Alexandr-Filatov/Invertor-Test/3D/Втулка М4 6х10.STEP

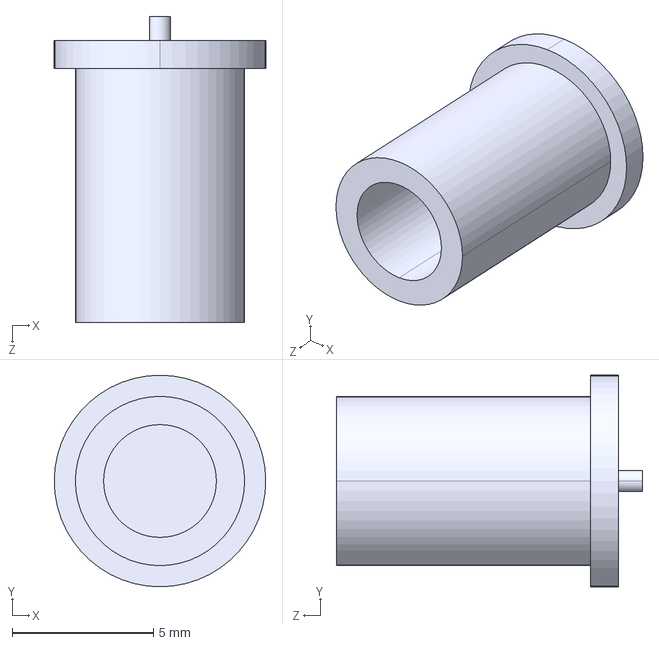
[picture p1: CAD file, 2024-11-04]
3D/Втулка М4 6х10.STEP
7.50 x 7.50 x 10.8 mm
