Alexandr-Filatov/Invertor-Test/3D/1-188275-0.stp

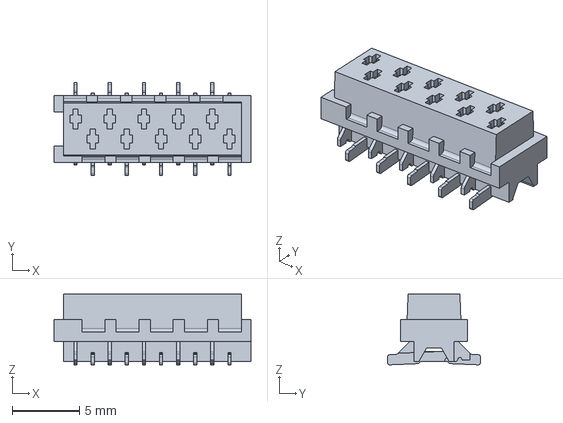
[picture p2: CAD file, 2024-11-04]
3D/1-188275-0.stp
14.6 x 6.90 x 5.25 mm
