Alexandr-Filatov/Invertor-Test/3D/PG-HSOF-8-1.STEP

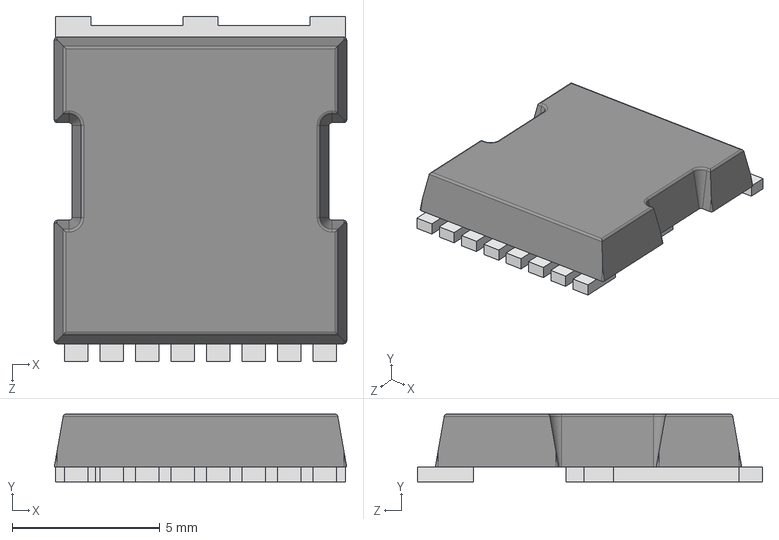
[picture p3: CAD file, 2024-11-04]
3D/PG-HSOF-8-1.STEP
9.90 x 2.30 x 11.7 mm
