Alexandr-Filatov/Invertor-Test/Power.kicad_pcb

## KiCad design Power.kicad_pcb (2024-11-04)

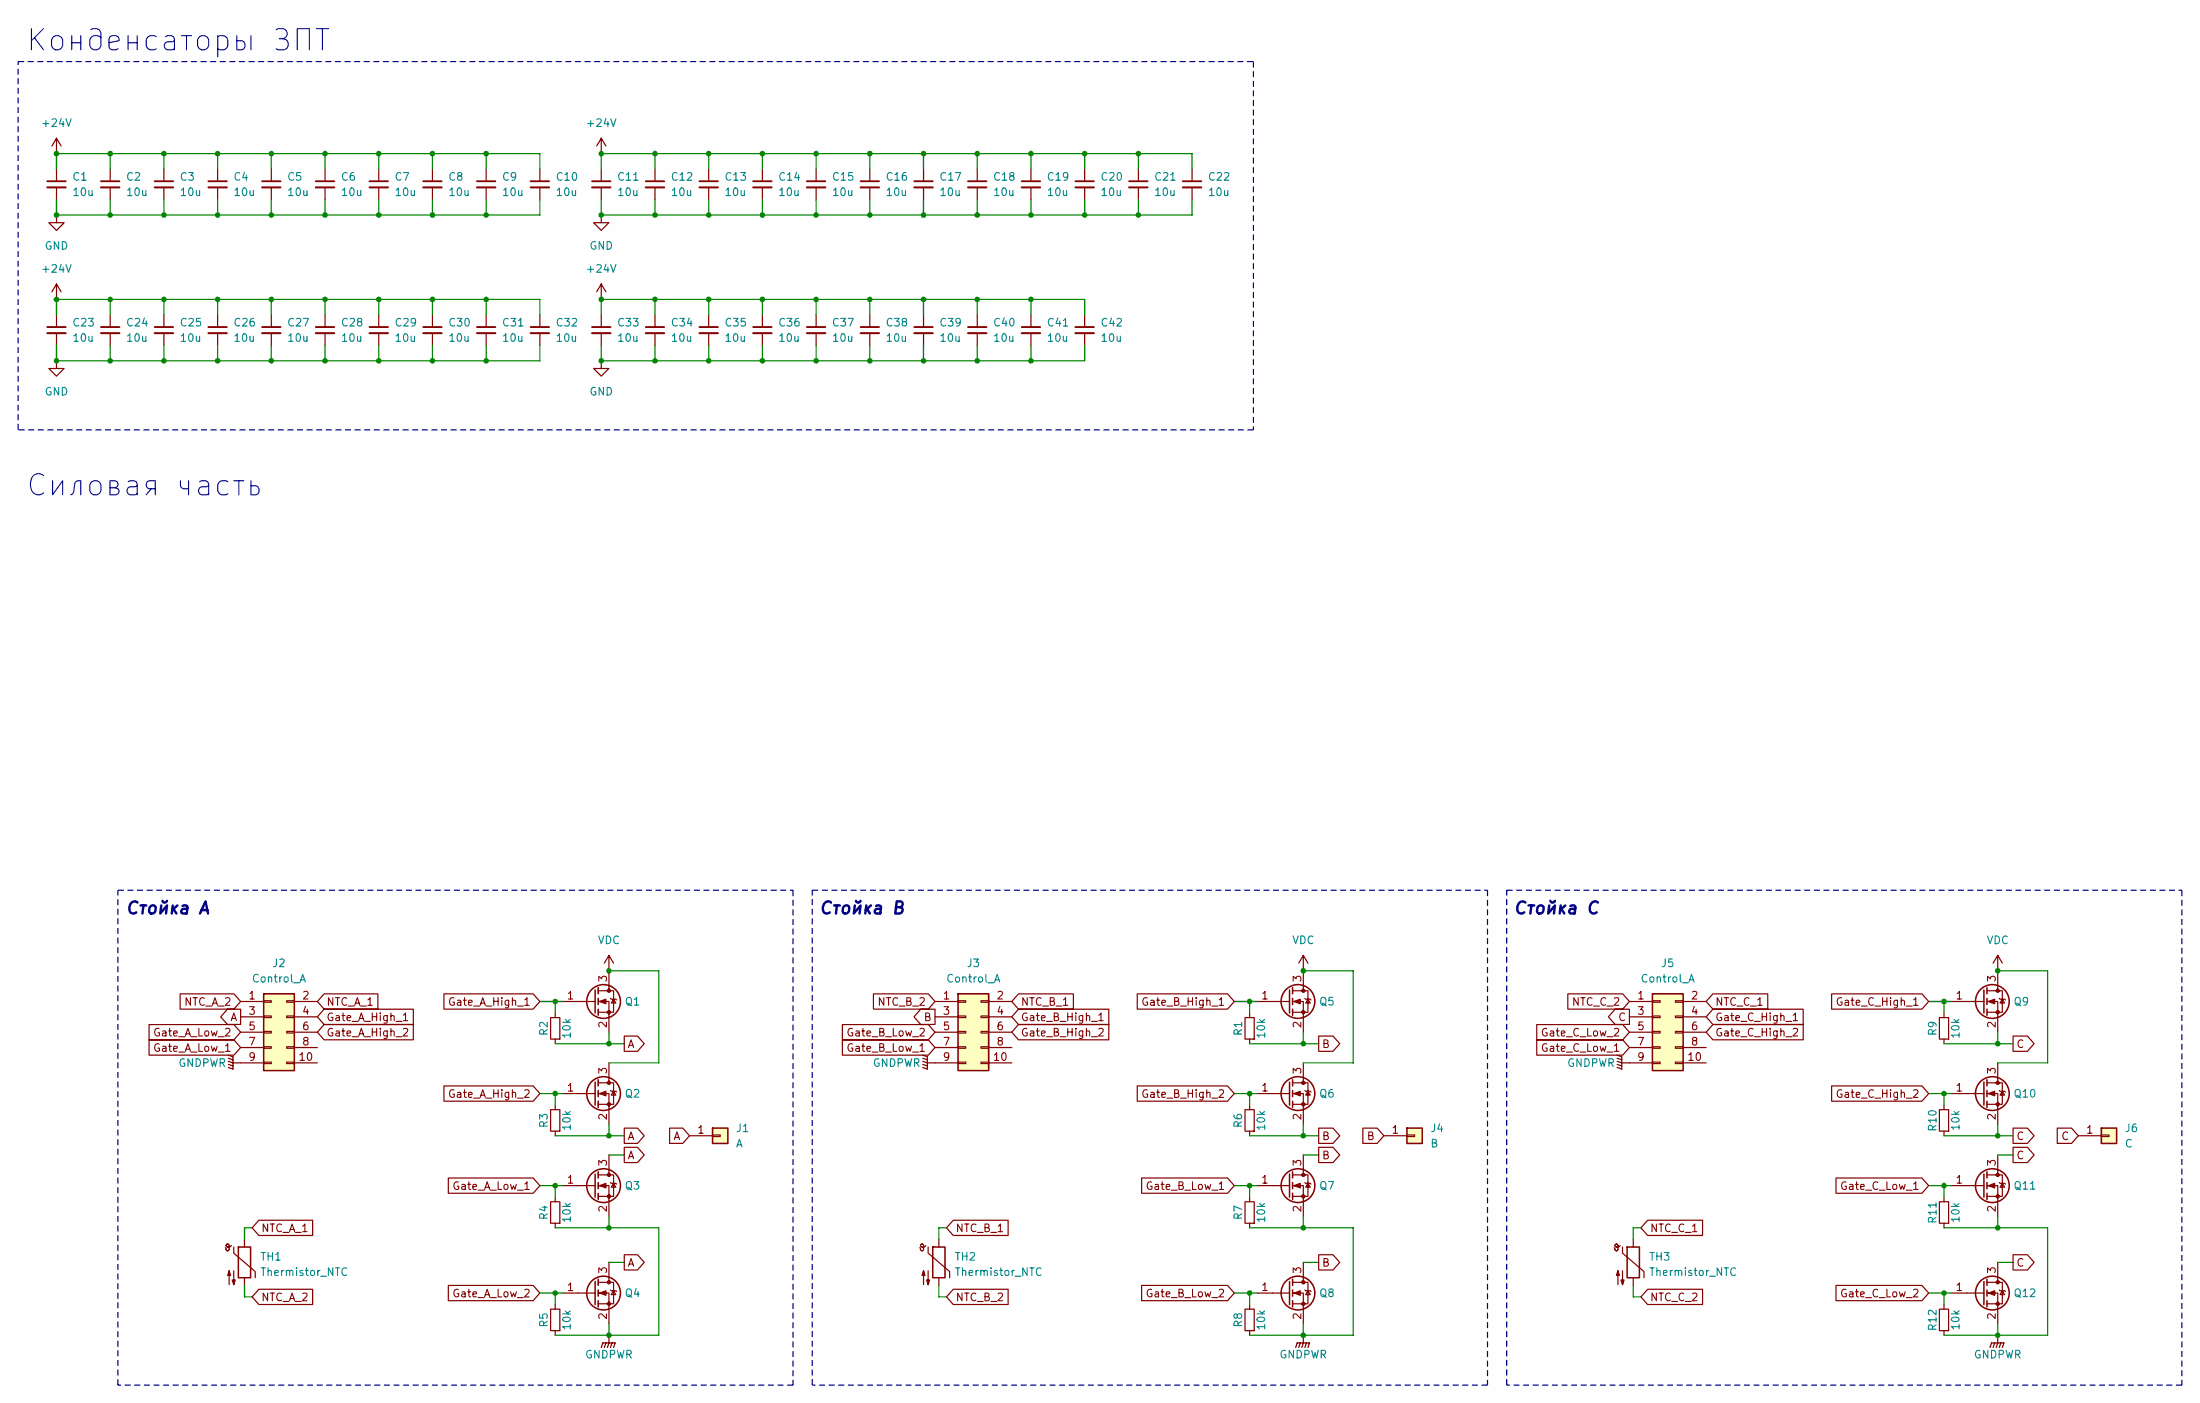
[picture p4: schematic Power.kicad_sch]

Parts:
C1, C2, C3, C4, C5, C6, C7, C8, C9, C10, C11, C12, C13, C14, C15, C16, C17, C18, C19, C20, C21, C22, C23, C24, C25, C26, C27, C28, C29, C30, C31, C32, C33, C34, C35, C36, C37, C38, C39, C40, C41, C42: 10u; C_1210_3225Metric_Pad1.33x2.70mm_HandSolder
J1: A; Bush_M4
J2, J3, J5: Control_A; 11882750
J4: B; Bush_M4
J6: C; Bush_M4
Q1, Q2, Q3, Q4, Q5, Q6, Q7, Q8, Q9, Q10, Q11, Q12: 2N7002; IPTG007N06NM5ATMA1
R1, R2, R3, R4, R5, R6, R7, R8, R9, R10, R11, R12: 10k; R_0805_2012Metric_Pad1.20x1.40mm_HandSolder
TH1, TH2, TH3: Thermistor_NTC; R_0603_1608Metric_Pad0.98x0.95mm_HandSolder

Connections:
+24V: C1.1, C2.1, C3.1, C4.1, C5.1, C6.1, C7.1, C8.1, C9.1, C10.1, C11.1, C12.1, C13.1, C14.1, C15.1, C16.1, C17.1, C18.1, C19.1, C20.1, C21.1, C22.1, C23.1, C24.1, C25.1, C26.1, C27.1, C28.1, C29.1, C30.1, C31.1, C32.1, C33.1, C34.1, C35.1, C36.1, C37.1, C38.1, C39.1, C40.1, C41.1, C42.1
A: J1.1, J2.3, Q1.2 (S), Q2.2 (S), Q3.3 (D), Q4.3 (D), R2.1, R3.1
B: J3.3, J4.1, Q5.2 (S), Q6.2 (S), Q7.3 (D), Q8.3 (D), R1.1, R6.1
C: J5.3, J6.1, Q9.2 (S), Q10.2 (S), Q11.3 (D), Q12.3 (D), R9.1, R10.1
GND: C1.2, C2.2, C3.2, C4.2, C5.2, C6.2, C7.2, C8.2, C9.2, C10.2, C11.2, C12.2, C13.2, C14.2, C15.2, C16.2, C17.2, C18.2, C19.2, C20.2, C21.2, C22.2, C23.2, C24.2, C25.2, C26.2, C27.2, C28.2, C29.2, C30.2, C31.2, C32.2, C33.2, C34.2, C35.2, C36.2, C37.2, C38.2, C39.2, C40.2, C41.2, C42.2
GNDPWR: J2.9, J3.9, J5.9, Q3.2 (S), Q4.2 (S), Q7.2 (S), Q8.2 (S), Q11.2 (S), Q12.2 (S), R4.1, R5.1, R7.1, R8.1, R11.1, R12.1
Gate_A_High_1: J2.4, Q1.1 (G), R2.2
Gate_A_High_2: J2.6, Q2.1 (G), R3.2
Gate_A_Low_1: J2.7, Q3.1 (G), R4.2
Gate_A_Low_2: J2.5, Q4.1 (G), R5.2
Gate_B_High_1: J3.4, Q5.1 (G), R1.2
Gate_B_High_2: J3.6, Q6.1 (G), R6.2
Gate_B_Low_1: J3.7, Q7.1 (G), R7.2
Gate_B_Low_2: J3.5, Q8.1 (G), R8.2
Gate_C_High_1: J5.4, Q9.1 (G), R9.2
Gate_C_High_2: J5.6, Q10.1 (G), R10.2
Gate_C_Low_1: J5.7, Q11.1 (G), R11.2
Gate_C_Low_2: J5.5, Q12.1 (G), R12.2
NTC_A_1: J2.2, TH1.1
NTC_A_2: J2.1, TH1.2
NTC_B_1: J3.2, TH2.1
NTC_B_2: J3.1, TH2.2
NTC_C_1: J5.2, TH3.1
NTC_C_2: J5.1, TH3.2
VDC: Q1.3 (D), Q2.3 (D), Q5.3 (D), Q6.3 (D), Q9.3 (D), Q10.3 (D)

Notes on the sheet:
Стойка А
Стойка B
Силовая часть
Конденсаторы ЗПТ
Стойка C

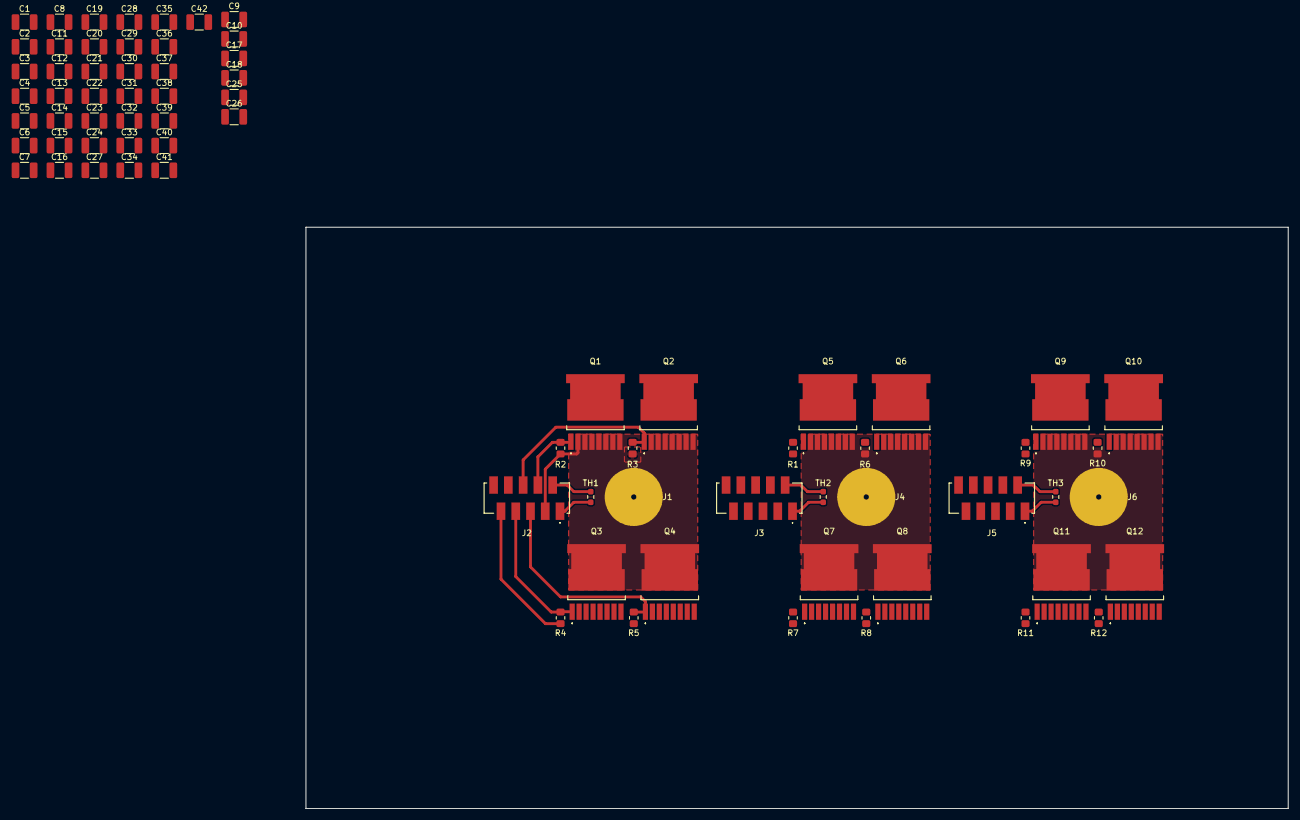
[picture p5: board Power.kicad_pcb from above]

Board: 2 copper layers, 169.0 x 100.0 mm, 75 parts (0 on the bottom side), 25 nets.
